wheeler-microfluidics/kicad___HIH6000-breakout/(commit log)

2016-04-15 Flip connector so that we can use single-sided PCB
    [HIH6000-breakout.kicad_pcb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]
2016-04-19 Flip connector and add mounting holes
    [HIH6000-breakout.kicad_pcb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]
2016-04-19 Modify gerber extensions and plot mask, edge cuts, etc.
    [HIH6000-breakout-B.Cu.gbl, HIH6000-breakout-B.Mask.gbs, HIH6000-breakout-B.Paste.gbp, HIH6000-breakout-B.SilkS.gbo, HIH6000-breakout-Edge.Cuts.gm1, HIH6000-breakout-F.Cu.gtl, HIH6000-breakout-F.Mask.gts, HIH6000-breakout-F.Paste.gtp]
2016-04-21 Add capacitor values and use HE10-10C connector
